augusthultman/KiCad_lib/(commit log)

2024-09-22 Add resistors and py scripts for generation of these
2026-03-07 Many changes...
    [pyvenv.cfg]
